houmei/SORDm5/README.md

# SORD m5 project
## SORDM5C - Cartridge board for SORD m5
## SORDM5PSA - Power Supply
