houmei/SORDm5/SORDM5C/README.md

# SORDM5C - Cartridge board for SORD m5 (KiCad5)

Schematic
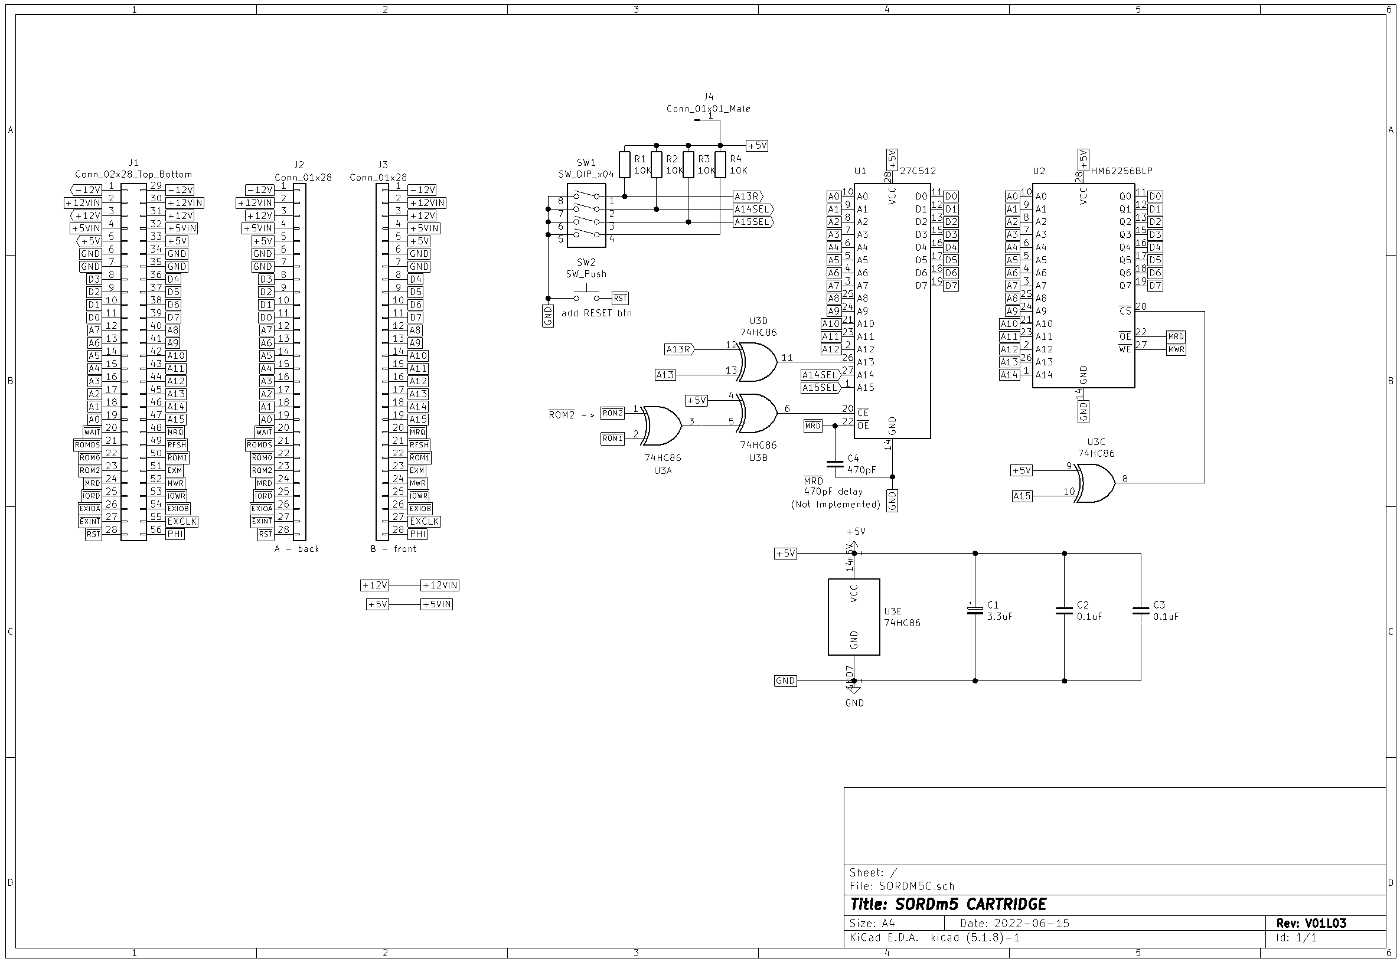
[picture p1: SORDM5C/img/SORDm5CV01L03-sch.png]
schematic


PCB
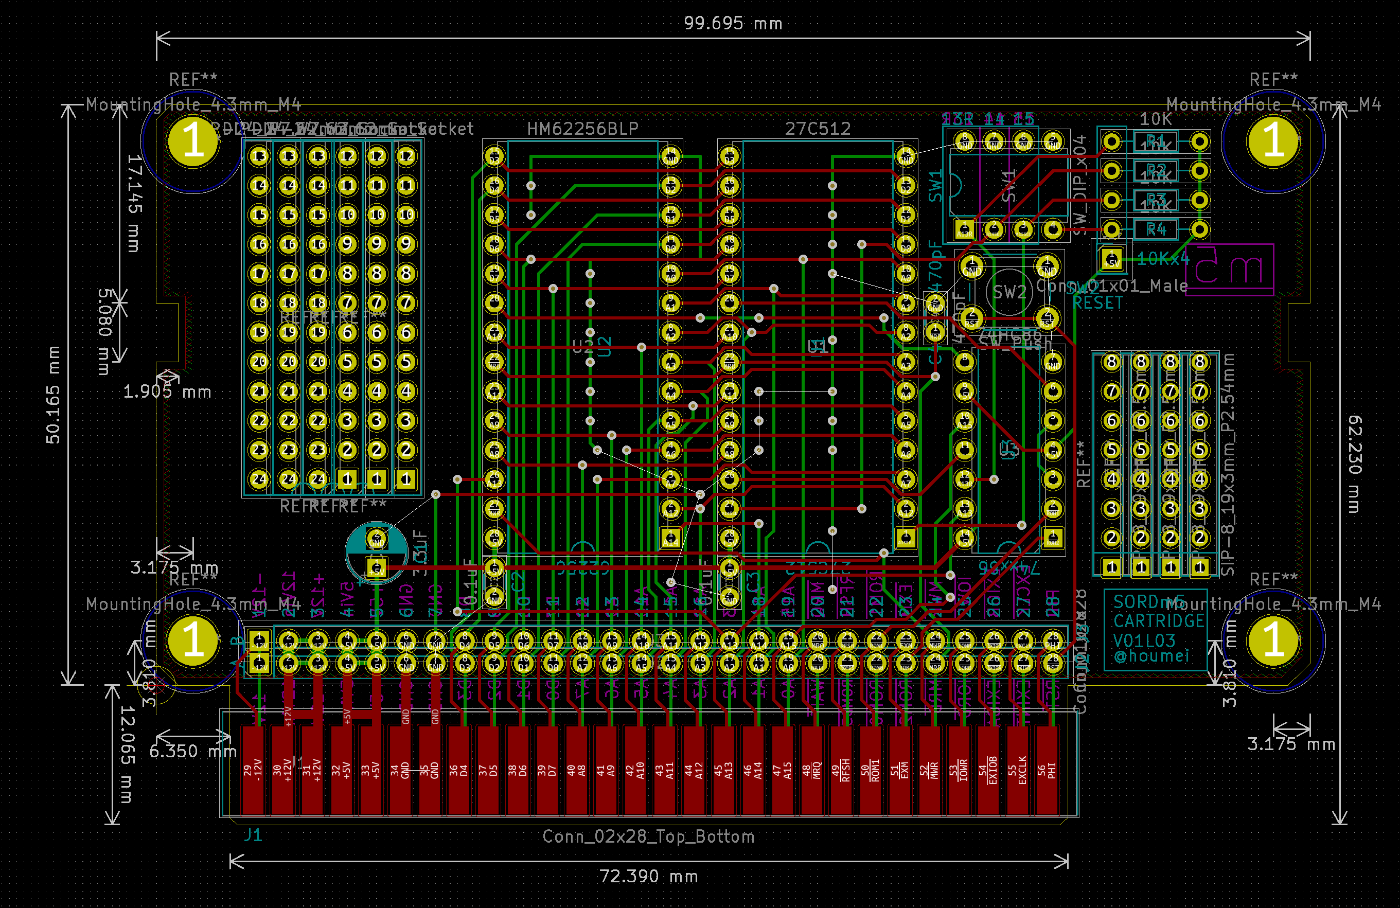
[picture p2: SORDM5C/img/SORDm5CV01L03-pcb.png]
pcb


## 説明

[SORDm5C V01L02 SORD m5用ROM/RAMカートリッジ](http://blog.livedoor.jp/hardyboy/archives/10058478.html "まごころせいじつ堂")  
[SORD m5用ROM/RAMカートリッジ基板](https://keisanki.booth.pm/items/3939000 "booth")  
・C4 470pFは不要です(元々のカートリッジでは~MRD信号を遅らせるために付いていたがU3で確保できている)  
・カードエッジ端面はやすりなどで角を面取りしてください。  

## 履歴
V01L01(非公開) 初版 ROMデコードの配線ミスあり  
V01L02(非公開) V01L01のデコード修正　リセットボタン追加  
V01L03 リセットボタンの形状変更　カードエッジの位置をずらしケースとの干渉を改善　回路図はV01L02と変わらず    

## SORDM5CV01L03GB - Gerber
JLCPCBなどにそのまま出図可能です。
