houmei/SORDm5/SORDM5C/SORDM5C.kicad_pcb

## KiCad design SORDM5C/SORDM5C.kicad_pcb (2022-11-20)

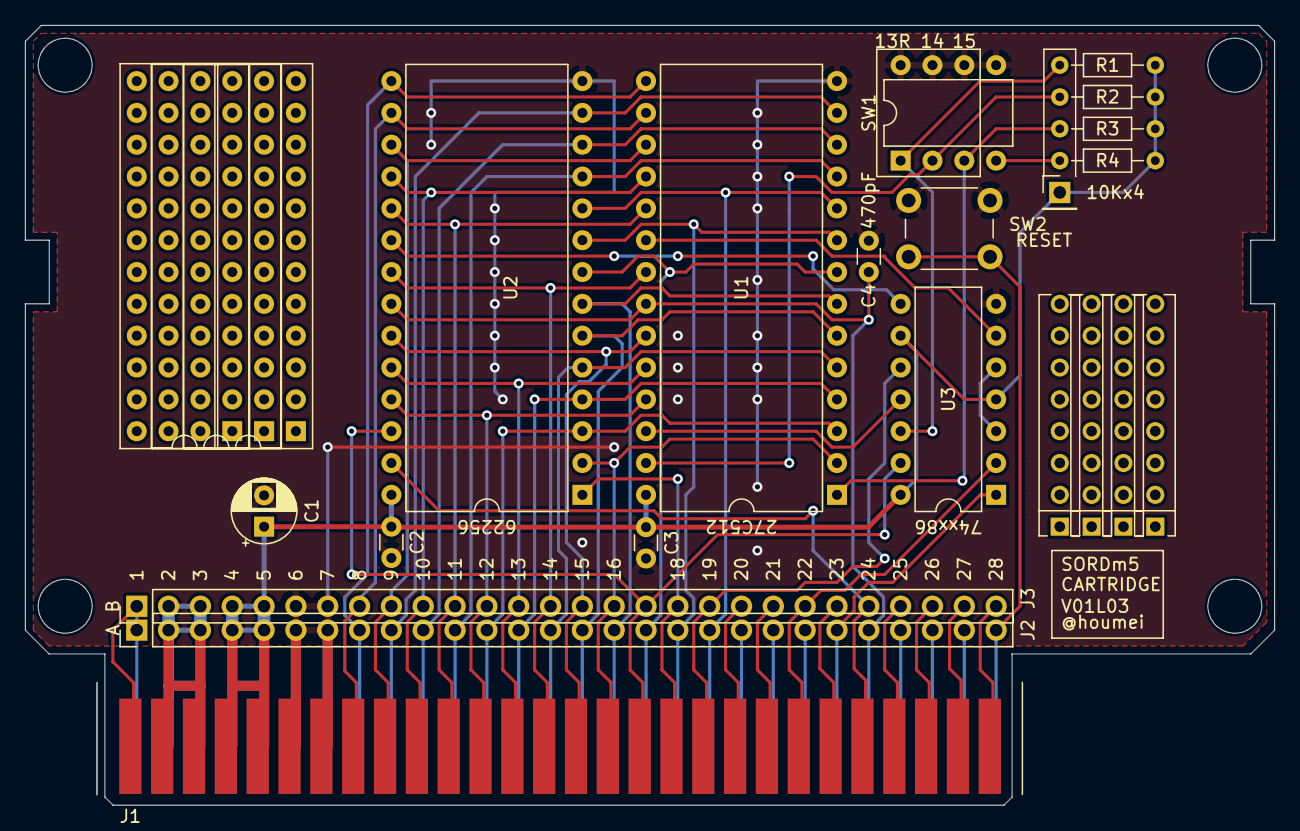
[picture p3: board SORDM5C.kicad_pcb from above]

Board: 2 copper layers, 99.7 x 62.2 mm, 17 parts (0 on the bottom side), 54 nets.

Parts:
C1: 3.3uF; CP_Radial_D5.0mm_P2.50mm
C2, C3: 0.1uF; C_Disc_D3.0mm_W1.6mm_P2.50mm
C4: 470pF; C_Disc_D3.0mm_W1.6mm_P2.50mm
J1: Conn_02x28_Top_Bottom; SORDm5_CARTRIDGE_28P
J2, J3: Conn_01x28; PinHeader_1x28_P2.54mm_Vertical
J4: Conn_01x01_Male; PinHeader_1x01_P2.54mm_Vertical
R1, R2, R3, R4: 10K; R_Axial_DIN0204_L3.6mm_D1.6mm_P7.62mm_Horizontal
SW1: SW_DIP_x04; DIP-8_W7.62mm
SW2: SW_Push; SW_PUSH_6mm
U1: 27C512; DIP-28_W15.24mm
U2: HM62256BLP; DIP-28_W15.24mm
U3: 74HC86; DIP-14_W7.62mm

Connections:
+5V: C1.1, C2.1, C3.1, J1.4, J1.5, J1.32, J1.33, J2.4, J2.5, J3.4, J3.5, J4.1, R1.1, R2.1, R3.1, R4.1, U1.28, U2.28, U3.4, U3.9, U3.14
+12V: J1.2, J1.3, J1.30, J1.31, J2.2, J2.3, J3.2, J3.3
-12V: J1.1, J1.29, J2.1, J3.1
A0: J1.19, J2.19, U1.10, U2.10
A1: J1.18, J2.18, U1.9, U2.9
A2: J1.17, J2.17, U1.8, U2.8
A3: J1.16, J2.16, U1.7, U2.7
A4: J1.15, J2.15, U1.6, U2.6
A5: J1.14, J2.14, U1.5, U2.5
A6: J1.13, J2.13, U1.4, U2.4
A7: J1.12, J2.12, U1.3, U2.3
A8: J1.40, J3.12, U1.25, U2.25
A9: J1.41, J3.13, U1.24, U2.24
A10: J1.42, J3.14, U1.21, U2.21
A11: J1.43, J3.15, U1.23, U2.23
A12: J1.44, J3.16, U1.2, U2.2
A13: J1.45, J3.17, U2.26, U3.13
A13R: R1.2, SW1.1, U3.12
A14: J1.46, J3.18, U2.1
A14SEL: R2.2, SW1.2, U1.27
A15: J1.47, J3.19, U3.10
A15SEL: R3.2, SW1.3, U1.1
D0: J1.11, J2.11, U1.11, U2.11
D1: J1.10, J2.10, U1.12, U2.12
D2: J1.9, J2.9, U1.13, U2.13
D3: J1.8, J2.8, U1.15, U2.15
D4: J1.36, J3.8, U1.16, U2.16
D5: J1.37, J3.9, U1.17, U2.17
D6: J1.38, J3.10, U1.18, U2.18
D7: J1.39, J3.11, U1.19, U2.19
EXCLK: J1.55, J3.27
GND: C1.2, C2.2, C3.2, C4.2, J1.6, J1.7, J1.34, J1.35, J2.6, J2.7, J3.6, J3.7, SW1.5, SW1.6, SW1.7, SW1.8, SW2.1, U1.14, U2.14, U3.7
unnamed: R4.2, SW1.4
unnamed: U1.20, U3.6
unnamed: U1.26, U3.11
unnamed: U2.20, U3.8
unnamed: U3.3, U3.5
PHI: J1.56, J3.28
~EXINT: J1.27, J2.27
~EXIOA: J1.26, J2.26
~EXIOB: J1.54, J3.26
~EXM: J1.51, J3.23
~IORD: J1.25, J2.25
~IOWR: J1.53, J3.25
~MRD: C4.1, J1.24, J2.24, U1.22, U2.22
~MRQ: J1.48, J3.20
~MWR: J1.52, J3.24, U2.27
~RFSH: J1.49, J3.21
~ROM0: J1.22, J2.22
~ROM1: J1.50, J3.22, U3.2
~ROM2: J1.23, J2.23, U3.1
~ROMDS: J1.21, J2.21
~RST: J1.28, J2.28, SW2.2
~WAIT: J1.20, J2.20
